Qeteshpony/DSL-Modem/README.md

# DSL-Modem Controller

A project to control a certain DSL-Modem through its internal serial port with a Raspberry Pi
