Qeteshpony/DSL-Modem/hardware/frontpanel_right.stl

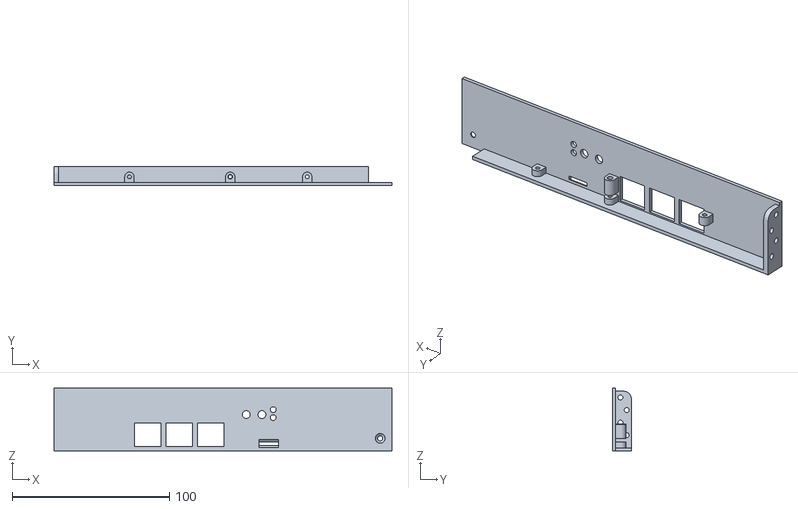
[picture p2: CAD file, 2023-10-18]
hardware/frontpanel_right.stl
215.0 x 12.0 x 40.0
