Qeteshpony/DSL-Modem/hardware/backpanel.stl

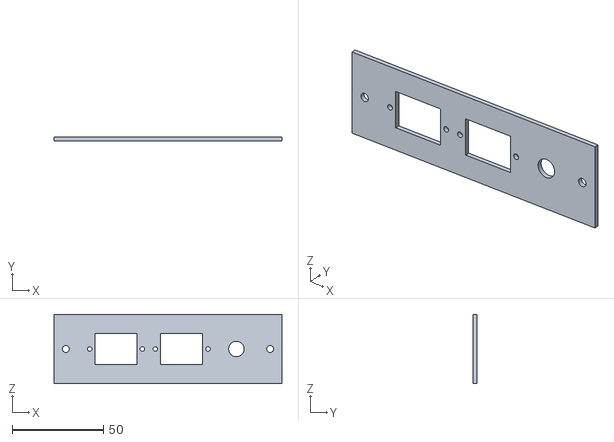
[picture p3: CAD file, 2023-10-18]
hardware/backpanel.stl
125.0 x 2.00 x 38.0
