Qeteshpony/DSL-Modem/hardware/frontpanel_left.stl

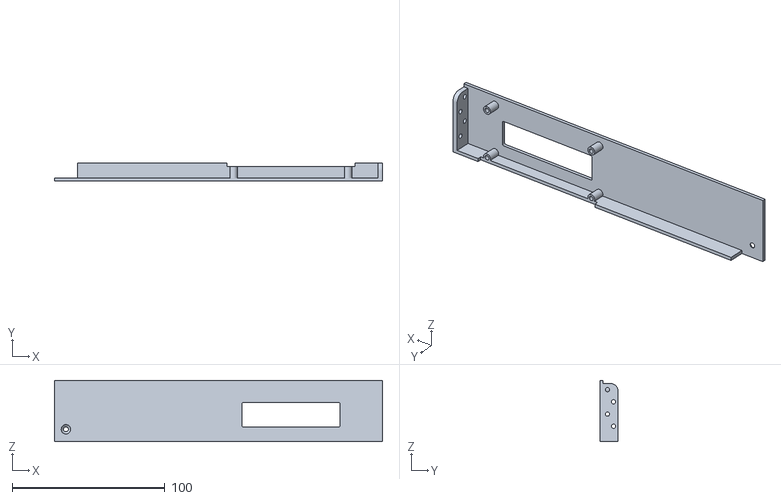
[picture p4: CAD file, 2023-10-18]
hardware/frontpanel_left.stl
215.0 x 12.0 x 40.0
