Qeteshpony/DSL-Modem/hardware/PCB/DSL-Modem.kicad_pcb

## KiCad design hardware/PCB/DSL-Modem.kicad_pcb (2023-10-18)

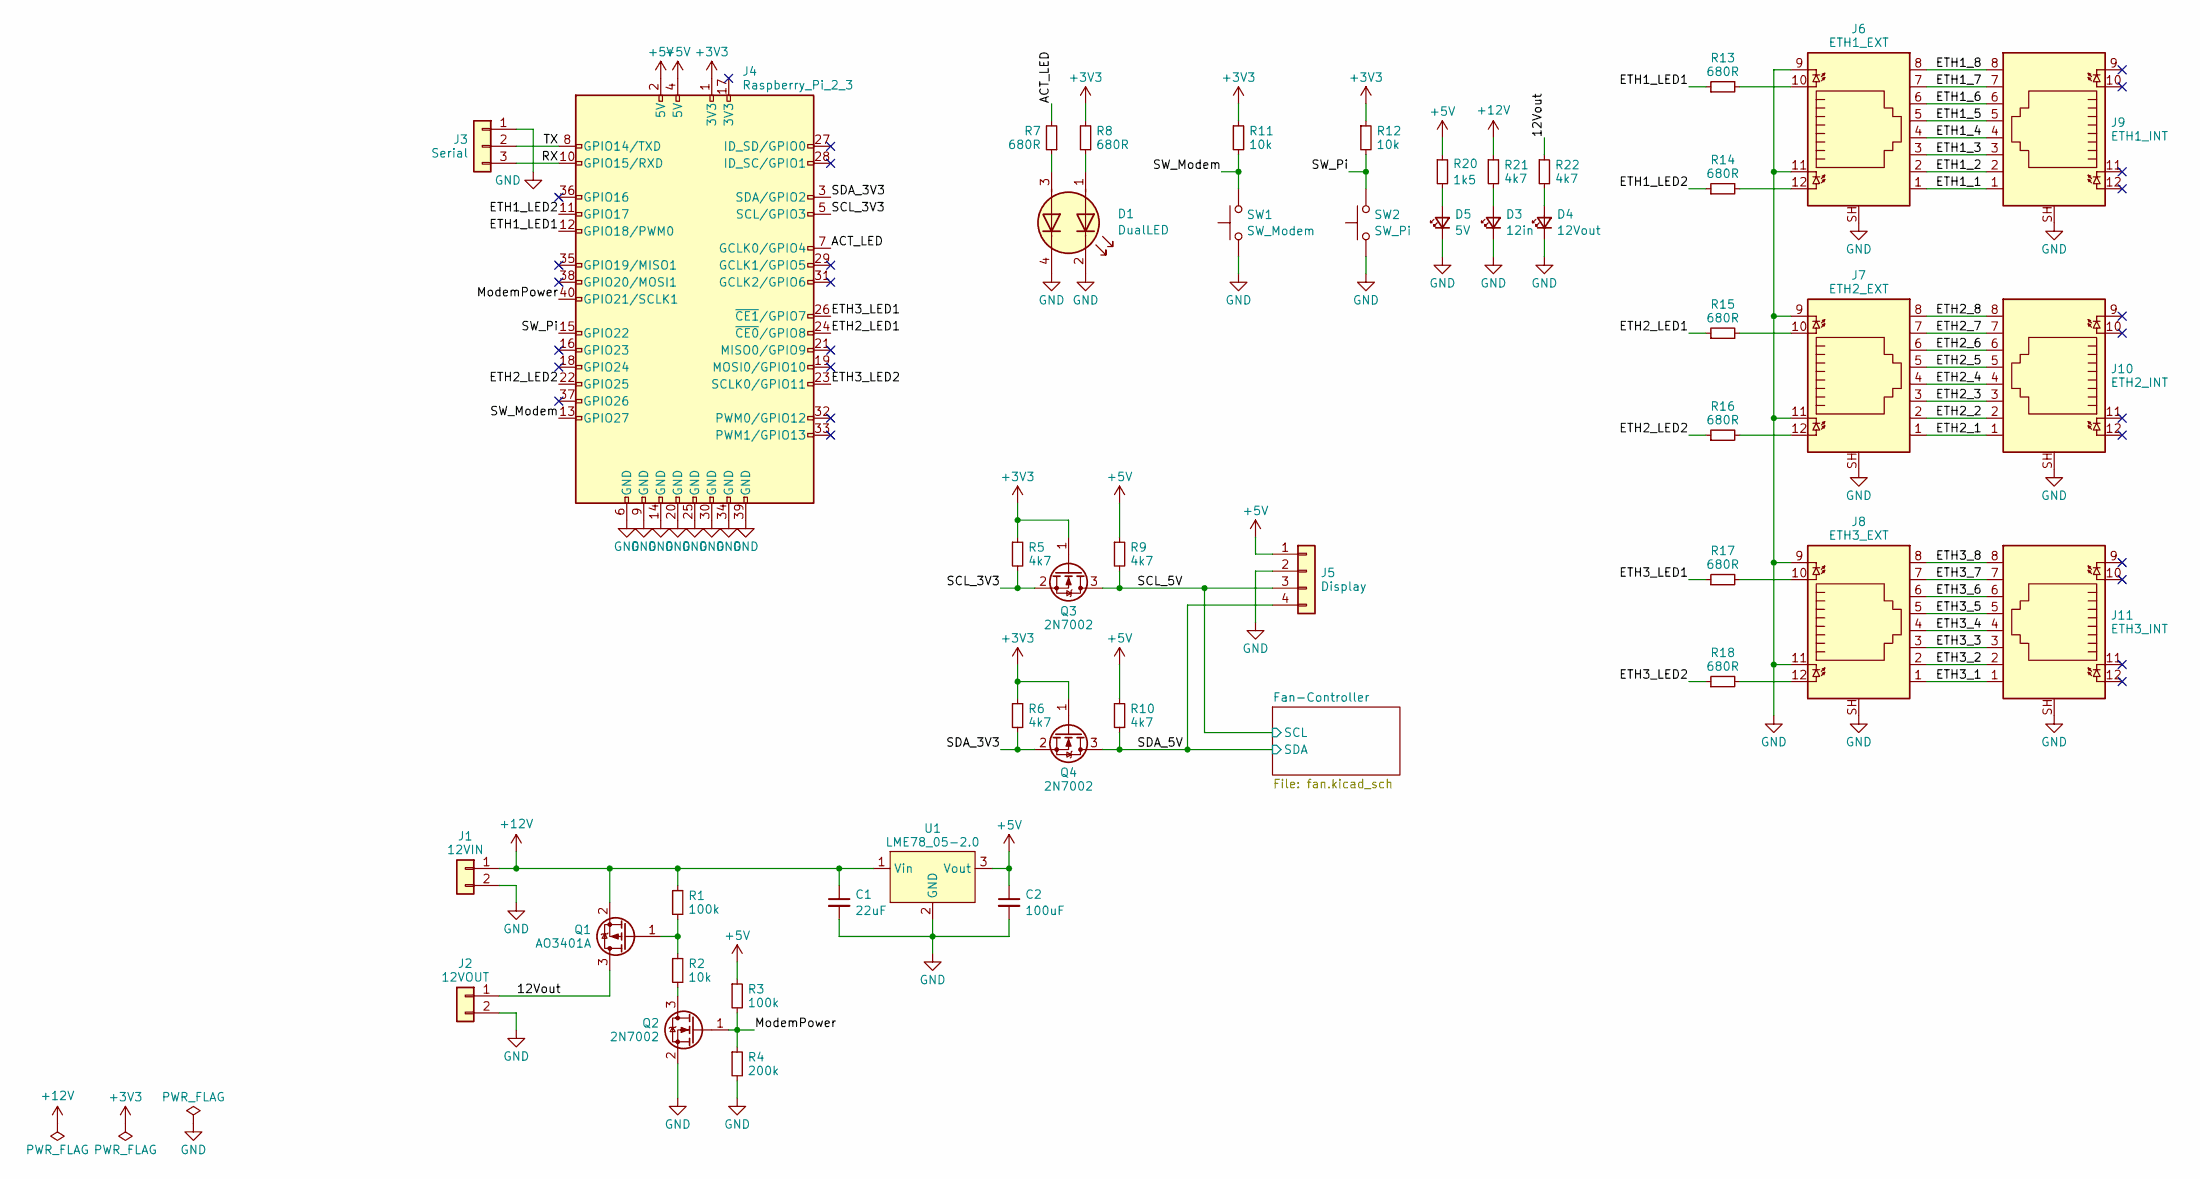
[picture p5: schematic DSL-Modem.kicad_sch]

Parts:
C1: 22uF; C_0805_2012Metric; LCSC C45783
C2: 100uF; C_1206_3216Metric; LCSC C15008
D1: DualLED; Everlight_Dual_LED_2x3mm
D3: 12in; LED_0603_1608Metric; LCSC C2286
D4: 12Vout; LED_0603_1608Metric; LCSC C2286
D5: 5V; LED_0603_1608Metric; LCSC C2286
J1: 12VIN; CTB9352-2
J2: 12VOUT; CTB9352-2
J3: Serial; PinHeader_1x03_P2.54mm_Vertical
J4: Raspberry_Pi_2_3; Raspberry Pi Universal Footprint
J5: Display; PinHeader_1x04_P2.54mm_Vertical
J6: ETH1_EXT; RJ45C5_R1D_3.2E4G-Y_RL
J7: ETH2_EXT; RJ45C5_R1D_3.2E4G-Y_RL
J8: ETH3_EXT; RJ45C5_R1D_3.2E4G-Y_RL
J9: ETH1_INT; RJ45C5_R1D_3.2E4G-Y_RL
J10: ETH2_INT; RJ45C5_R1D_3.2E4G-Y_RL
J11: ETH3_INT; RJ45C5_R1D_3.2E4G-Y_RL
Q1: AO3401A; SOT-23; LCSC C15127
Q2, Q3, Q4: 2N7002; SOT-23; LCSC C8545
R1, R3: 100k; R_0603_1608Metric; LCSC C25803
R2, R11, R12: 10k; R_0603_1608Metric; LCSC C25804
R4: 200k; R_0603_1608Metric; LCSC C25811
R5, R6, R9, R10, R21, R22: 4k7; R_0603_1608Metric; LCSC C23162
R7, R8, R13, R14, R15, R16, R17, R18: 680R; R_0603_1608Metric; LCSC C23228
R20: 1k5; R_0603_1608Metric; LCSC C22843
SW1: SW_Modem; SW_Tactile_SPST_Angled_PTS645Vx83-2LFS
SW2: SW_Pi; SW_Tactile_SPST_Angled_PTS645Vx83-2LFS
U1: LME78_05-2.0; LME78_1.0-Series

Connections:
+3V3: J4.1 (3V3), Q3.1 (G), Q4.1 (G), R5.1, R6.1, R8.2, R11.1, R12.1
+12V: C1.1, J1.1, Q1.2 (S), R1.1, R21.1, U1.1 (Vin); also elsewhere on the board
/12Vout: J2.1, Q1.3 (D), R22.1
/ACT_LED: J4.7 (GCLK0/GPIO4), R7.2
/ETH1_1: J6.1, J9.1
/ETH1_2: J6.2, J9.2
/ETH1_3: J6.3, J9.3
/ETH1_4: J6.4, J9.4
/ETH1_5: J6.5, J9.5
/ETH1_6: J6.6, J9.6
/ETH1_7: J6.7, J9.7
/ETH1_8: J6.8, J9.8
/ETH1_LED1: J4.12 (GPIO18/PWM0), R13.1
/ETH1_LED2: J4.11 (GPIO17), R14.1
/ETH2_1: J7.1, J10.1
/ETH2_2: J7.2, J10.2
/ETH2_3: J7.3, J10.3
/ETH2_4: J7.4, J10.4
/ETH2_5: J7.5, J10.5
/ETH2_6: J7.6, J10.6
/ETH2_7: J7.7, J10.7
/ETH2_8: J7.8, J10.8
/ETH2_LED1: J4.24 (~CE0/GPIO8), R15.1
/ETH2_LED2: J4.22 (GPIO25), R16.1
/ETH3_1: J8.1, J11.1
/ETH3_2: J8.2, J11.2
/ETH3_3: J8.3, J11.3
/ETH3_4: J8.4, J11.4
/ETH3_5: J8.5, J11.5
/ETH3_6: J8.6, J11.6
/ETH3_7: J8.7, J11.7
/ETH3_8: J8.8, J11.8
/ETH3_LED1: J4.26 (~CE1/GPIO7), R17.1
/ETH3_LED2: J4.23 (SCLK0/GPIO11), R18.1
/ModemPower: J4.40 (GPIO21/SCLK1), Q2.1 (G), R3.2, R4.1
/RX: J3.3, J4.10 (GPIO15/RXD)
/SCL_3V3: J4.5 (SCL/GPIO3), Q3.2 (S), R5.2
/SCL_5V: J5.3, Q3.3 (D), R9.2; also elsewhere on the board
/SDA_3V3: J4.3 (SDA/GPIO2), Q4.2 (S), R6.2
/SDA_5V: J5.4, Q4.3 (D), R10.2; also elsewhere on the board
/SW_Modem: J4.13 (GPIO27), R11.2, SW1.2
/SW_Pi: J4.15 (GPIO22), R12.2, SW2.2
/TX: J3.2, J4.8 (GPIO14/TXD)
unnamed: D1.1 (A1), R8.1
unnamed: D1.3 (A2), R7.1
unnamed: D3.2 (A), R21.2
unnamed: D4.2 (A), R22.2
unnamed: D5.2 (A), R20.2
unnamed: J6.10, R13.2
unnamed: J6.12, R14.2
unnamed: J7.10, R15.2
unnamed: J7.12, R16.2
unnamed: J8.10, R17.2
unnamed: J8.12, R18.2
unnamed: Q1.1 (G), R1.2, R2.1
unnamed: Q2.3 (D), R2.2

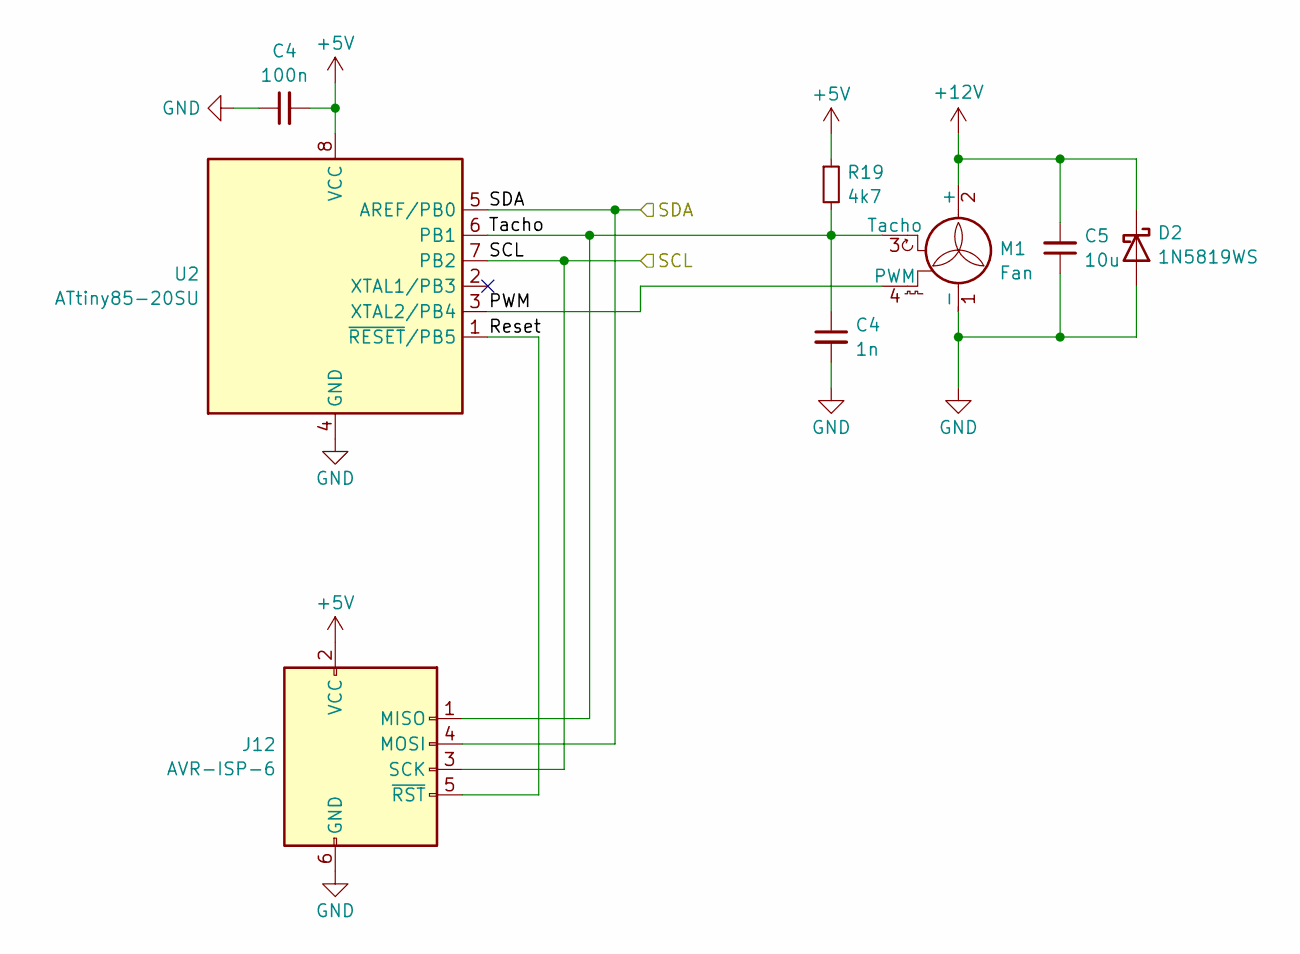
[picture p6: schematic fan.kicad_sch]

Parts:
C4: 1n; C_0603_1608Metric; LCSC C1588
C5: 10u; C_0603_1608Metric; LCSC C96446
D2: 1N5819WS; D_SOD-323; LCSC C191023
J12: AVR-ISP-6; PinHeader_2x03_P2.54mm_Vertical
M1: Fan; FanPinHeader_1x04_P2.54mm_Vertical
R19: 4k7; R_0603_1608Metric; LCSC C23162
U2: ATtiny85-20SU; SOIC-8W_5.3x5.3mm_P1.27mm

Connections:
+12V: C5.2, D2.1 (K), M1.2 (+); also elsewhere on the board
/Fan-Controller/PWM: M1.4 (PWM), U2.3 (XTAL2/PB4)
/Fan-Controller/Reset: J12.5 (~RST), U2.1 (~RESET/PB5)
/SCL_5V: J12.3 (SCK), U2.7 (PB2); also elsewhere on the board
/SDA_5V: J12.4 (MOSI), U2.5 (AREF/PB0); also elsewhere on the board

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
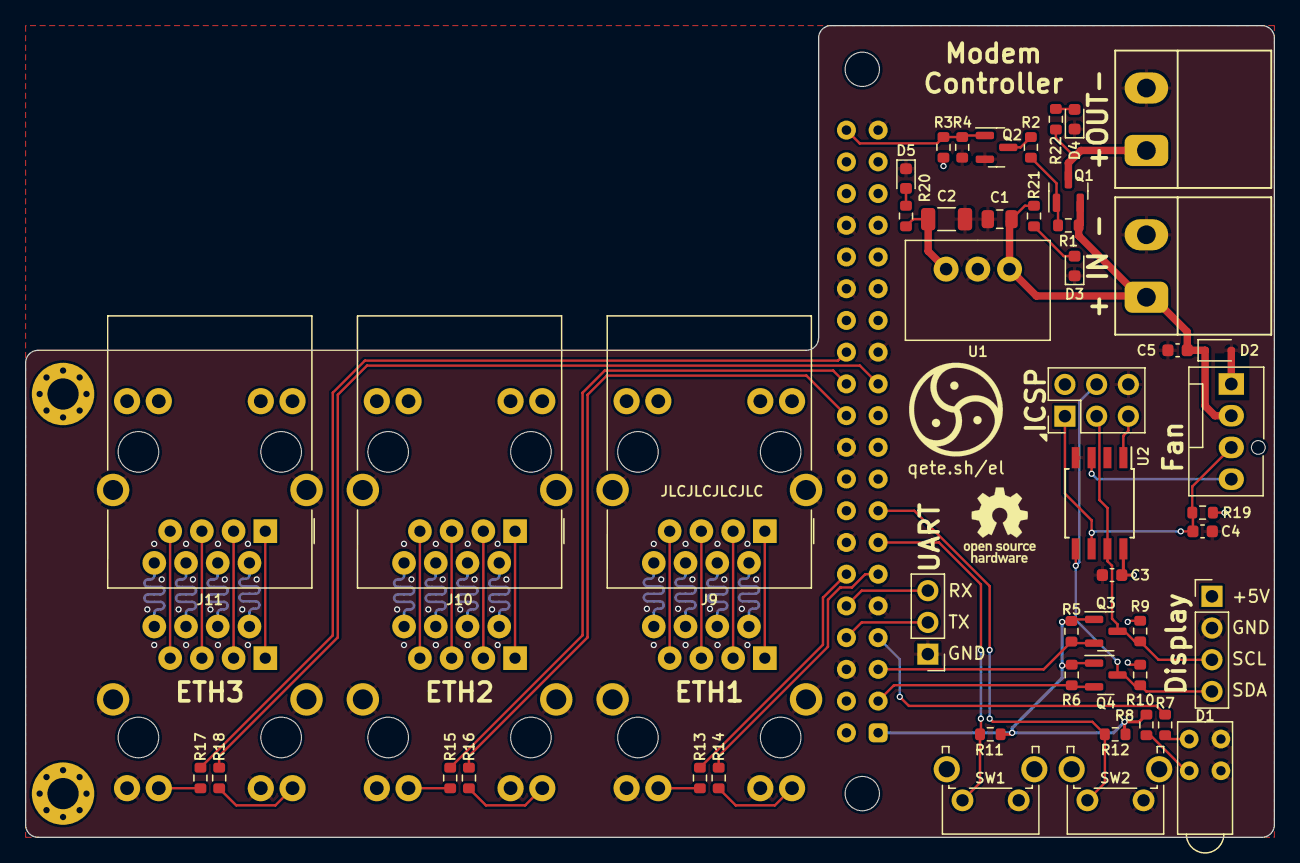
[picture p7: board DSL-Modem.kicad_pcb from above]

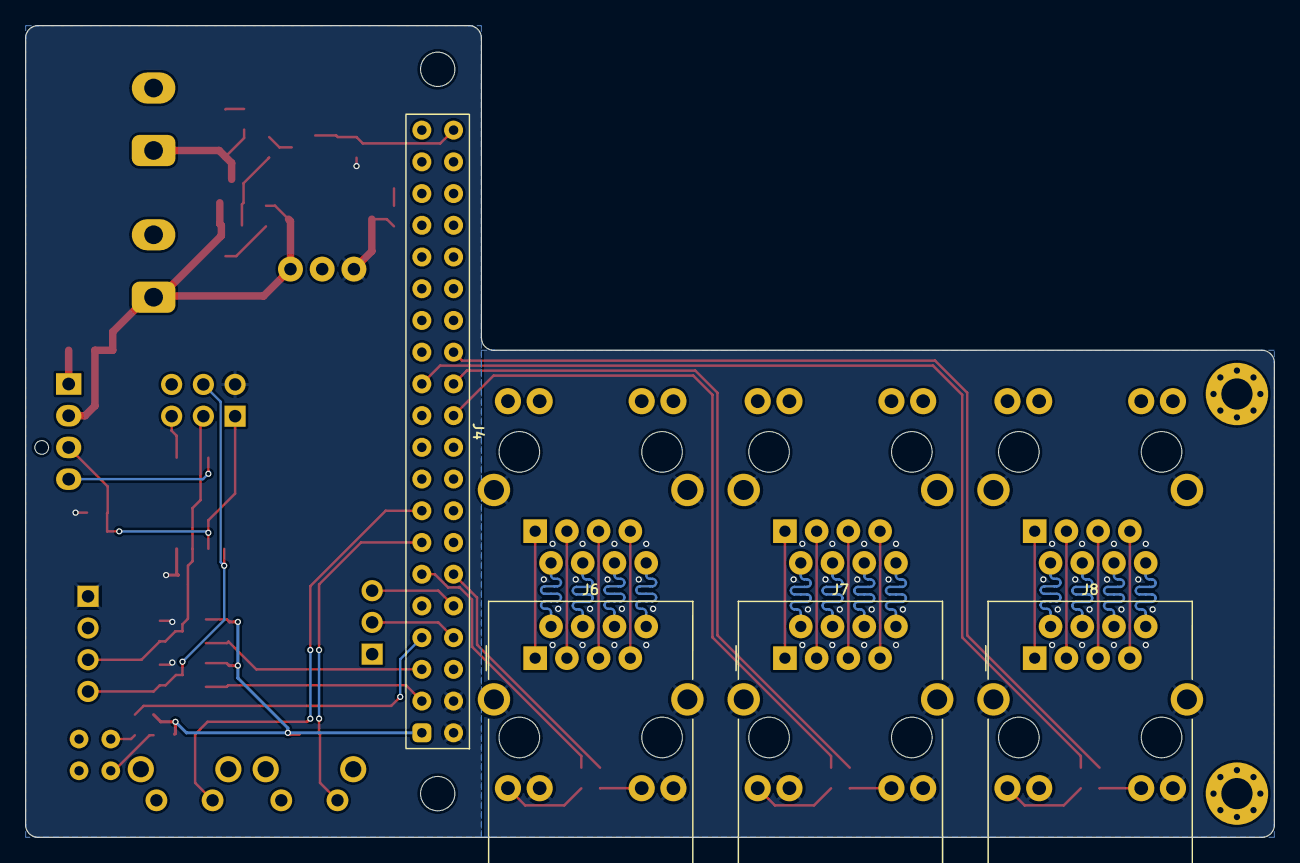
[picture p8: board DSL-Modem.kicad_pcb from below]

Board: 2 copper layers, 100.0 x 65.0 mm, 53 parts (3 on the bottom side), 61 nets.

Other parts of the board:
C3: 100n; C_0603_1608Metric
