Qeteshpony/DSL-Modem/(commit log)

2023-10-18 fix: automatic restart of mqtt client
    [modemcontroller.py, mqtt.py]
2023-10-18 feat: add hardware sources
    [DSL-Modem.kicad_pcb, DSL-Modem.kicad_sch, backpanel.stl, fan.kicad_sch, frontpanel_left.stl, frontpanel_right.stl]
2023-10-20 fix: automatic recovery from wrong prompt
    [modemcontroller.py]
2023-11-03 fix: change restart interval in case of failure
2023-11-03 fix: add try-block in case of connection problems
    [mqtt.py]
2024-01-26 fix: retain MQTT messages for sensor data
    [modemcontroller.py]
2024-07-17 fix: catch more exceptions
    Since communication with the modem is sometimes unreliable we need to catch more exceptions
    [modemcontroller.py]
2025-11-01 fix: try to fix occasional hangs in serial connection
    [modemcontroller.py]
2026-11-05 fix: daemonize LEDThread
2026-11-05 fix: make updateDisplay thread-safe
2026-11-05 feat: add some more sensors, remove unneeded ones
